SEGAINVEX-ELECTRONICA/Fuente_de_corriente_y_amplificador_bajo_ruido/readme.md

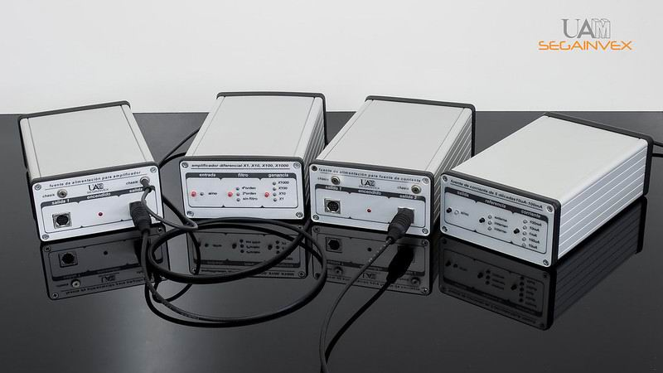
[picture p1: Fotos/IMG0.jpg]
Optional title

# UNIVERSIDAD AUTÓNOMA DE MADRID
# SEGAINVEX-Electrónica
Patricio Coronado Collado marzo 2015
# DESCRIPCIÓN
Fuentes de corriente de bajo ruido 1mA-100mA y 100nA a 1mA y amplificador diferencial con ganancias de 1 a 1000
Desarrollado por SEGAINVEX-Electrónica para el Departamento de Física de la Materia
Condensada de la UAM https://www.fmc.uam.es/
# FOTOS
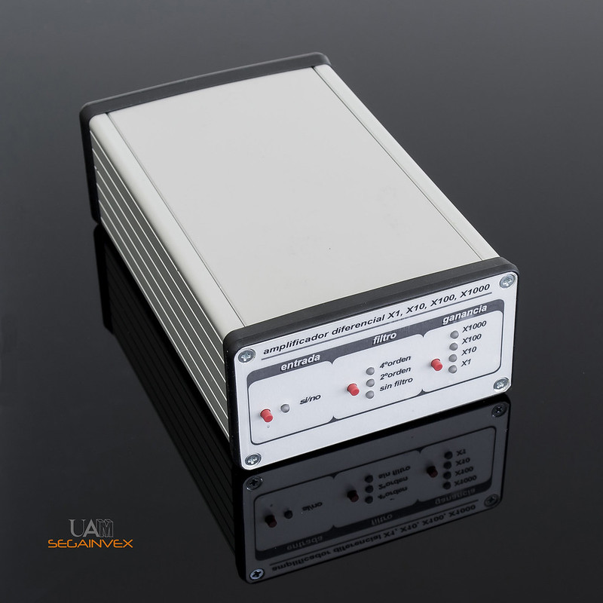
[picture p2: Fotos/IMG1.jpg]
amplificador

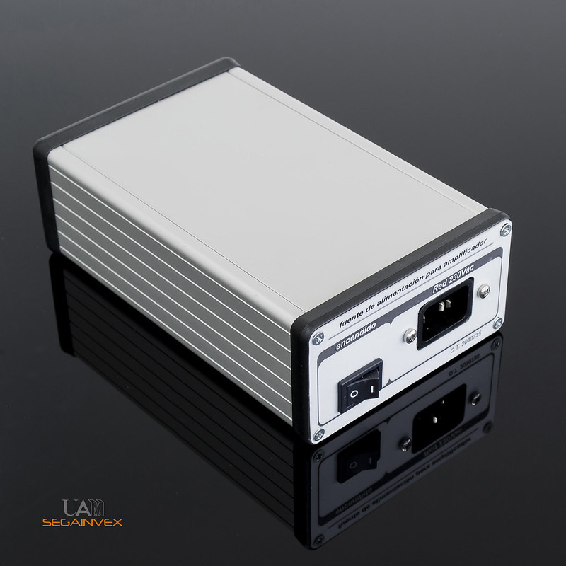
[picture p3: Fotos/IMG2.jpg]
fuente de alimentación

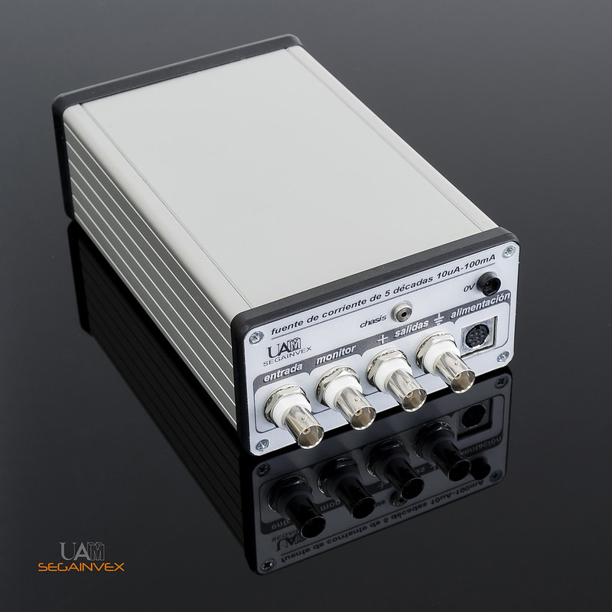
[picture p4: Fotos/IMG3.jpg]
fuente de corriente

### publicado desde "D:\Proyectos\Fuente corriente bajo riudo GitHub"
