SEGAINVEX-ELECTRONICA/Fuente_de_corriente_y_amplificador_bajo_ruido/amplificador_firmware_P89LPC935_P89LPC933/Configuración de puertos P89LPC933.JPG

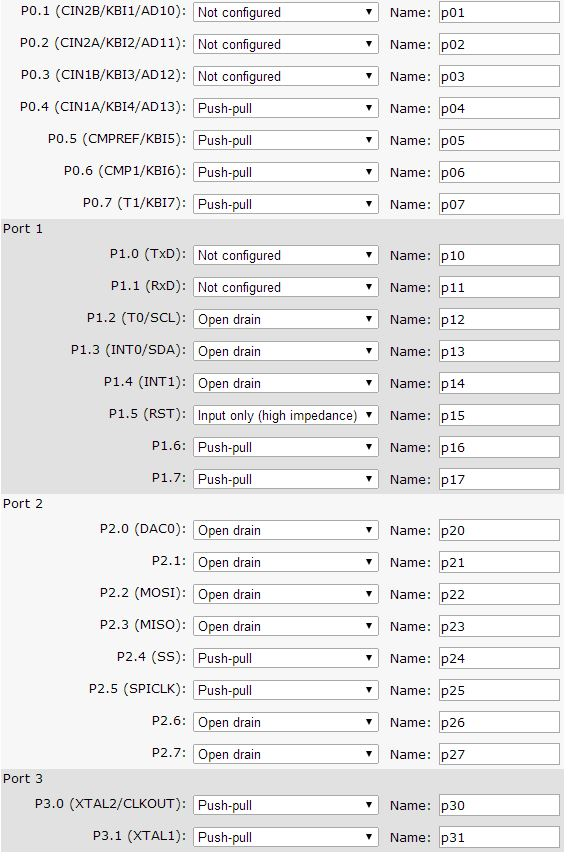
amplificador_firmware_P89LPC935_P89LPC933/Configuración de puertos P89LPC933.JPG
