SEGAINVEX-ELECTRONICA/Fuente_de_corriente_y_amplificador_bajo_ruido/(list of files, cad)

Other CAD files:
amplificador_firmware_P89LPC935_P89LPC933/START900.OBJ
fuente_corriente_firmware_LPC933/START900.OBJ
amplificador_firmware_P89LPC935_P89LPC933/ControlFuenteCorriente.OBJ
fuente_corriente_firmware_LPC933/ControlFuenteCorriente.OBJ
amplificador_firmware_P89LPC935_P89LPC933/ControlDigitalAmpDifP89LPC935.OBJ
amplificador_firmware_P89LPC935_P89LPC933/eeprom.OBJ
