SEGAINVEX-ELECTRONICA/Fuente_de_corriente_y_amplificador_bajo_ruido/Manuales/Amplificador_manual.pdf

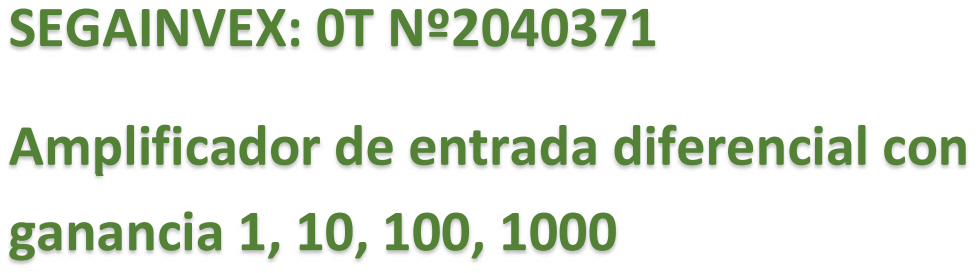
[picture p6: figure]
SEGAINVEX: 0T Nº2040371; Amplificador de entrada diferencial con ganancia 1, 10, 100, 1000
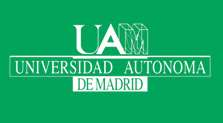
[picture p7: figure]

PARÁMETRO | VALOR
Ganancia | Seleccionable X1, X10, X100, X1000
Etapa de entrada | Diferencial
Rechazo al modo común CMRR | 100dB @ 20KHz y Ganancia 1000
Máximo voltaje de entrada diferencial | ±10V
Máximo voltaje de entrada modo común | ±9V @ (salida = ±10V) ±12V @(salida =±1V)
Impedancia de entrada diferencial | 4GΩ||1.25pF
Corriente de polarización de entrada | 5nA<50nA@25ºC
Voltaje de error de offset | -5mV @ (Ganancia=1000)
Ruido referido a la entrada (con filtro 2º orden) | 12,6nV/√Hz @(Ganancia=1000)
Corriente de salida en cortocircuito | 37mA
Ancho de Banda sin filtro | 64KHz @ (Ganancia=1000 y salida=±10V)
Ancho de Banda con filtro 2º orden | 45KHz @ (Ganancia=1000 y salida=±10V)
Ancho de Banda con filtro 4º orden | 38KHz @ (Ganancia=1000 y salida=±10V)
Máximo voltaje de salida | =±10V
Impedancia de salida | ≈ 0V
Corriente de salida en cortocircuito | ≈35mA
Potencia de la fuente de salida | 20W

### Entrada:

La entrada diferencial de señal se realiza a través de 2 conectores BNC aislados con la malla puesta a gnd (referencia de la electrónica del sistema), pero desconectada del chasis, que está completamente aislado. Para mayor flexibilidad, en el panel de conectores hay dos conectores para bornas de 2mm, conectadas una al chasis y otra a gnd.
Con el pulsador de esta etapa podemos conectar las entradas del amplificador a los conectores BNC (led encendido). O cortocircuitarlas y ponerlas a gnd, quedando los conectores BNC al aire (led apagado).

### Filtro:

Con el pulsador de filtro se puede conectar el BNC de salida a la salida del amplificador directamente (sin filtro). O a través de una etapa de filtrado de segundo orden (2º orden). O a través de dos etapas de filtrado de segundo orden (4º orden).

### Salida:

La salida se realiza a través de un conector tipo BNC aislado con la malla conectada a gnd.

### Alimentación:

La fuente de alimentación se conecta al amplificador con un conector MiniDin de 8 contactos

### 1 gnd digital 2 tierra 3 gnd digital 4 gnd analógica

5 +5V
6 -15V

### 7 gnd analógica

8 +15V

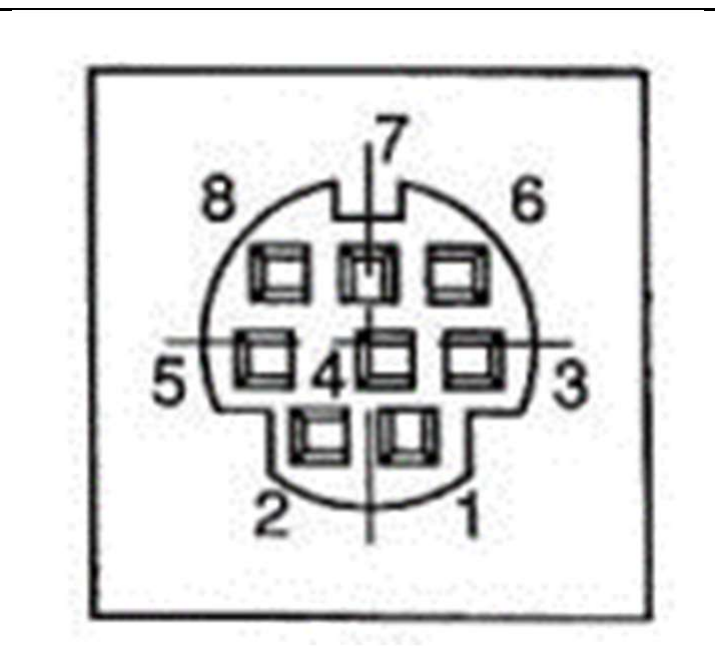
[picture p8: figure]

Por seguridad, el chasis de la fuente de alimentación está conectado a la tierra de la toma de tensión de red.

### Oscilogramas:

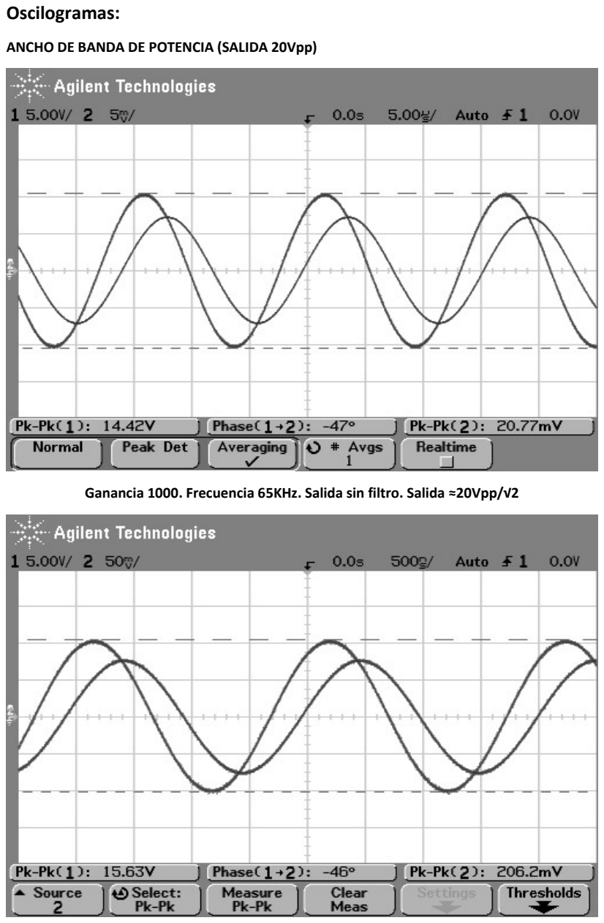
[picture p9: page 3]

ANCHO DE BANDA DE POTENCIA (SALIDA 20Vpp)

Ganancia 1000. Frecuencia 65KHz. Salida sin filtro. Salida ≈20Vpp/√2

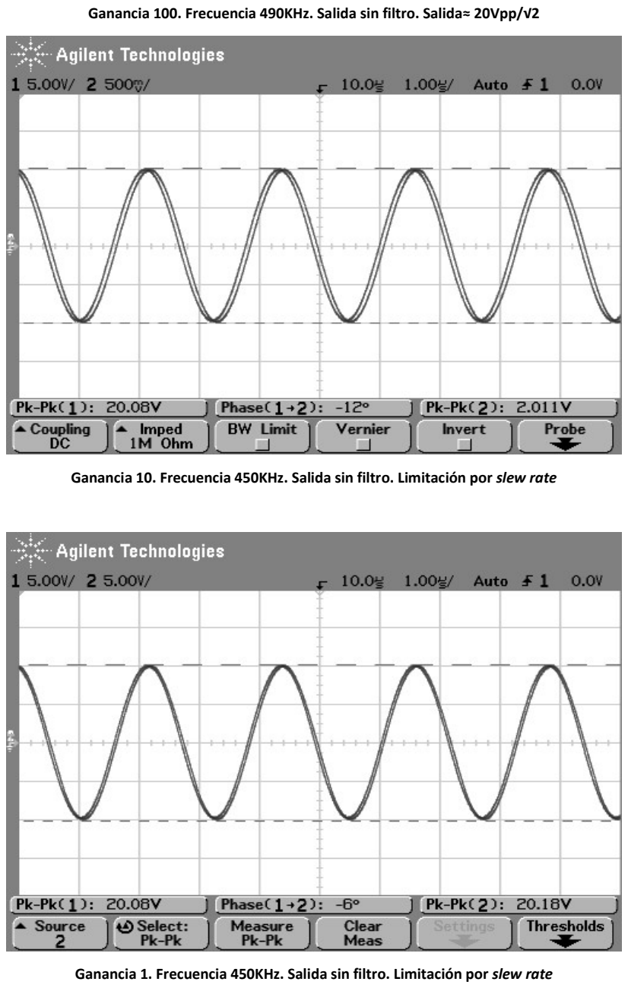
[picture p10: page 4]

Ganancia 100. Frecuencia 490KHz. Salida sin filtro. Salida≈ 20Vpp/√2

Ganancia 10. Frecuencia 450KHz. Salida sin filtro. Limitación por slew rate

Ganancia 1. Frecuencia 450KHz. Salida sin filtro. Limitación por slew rate

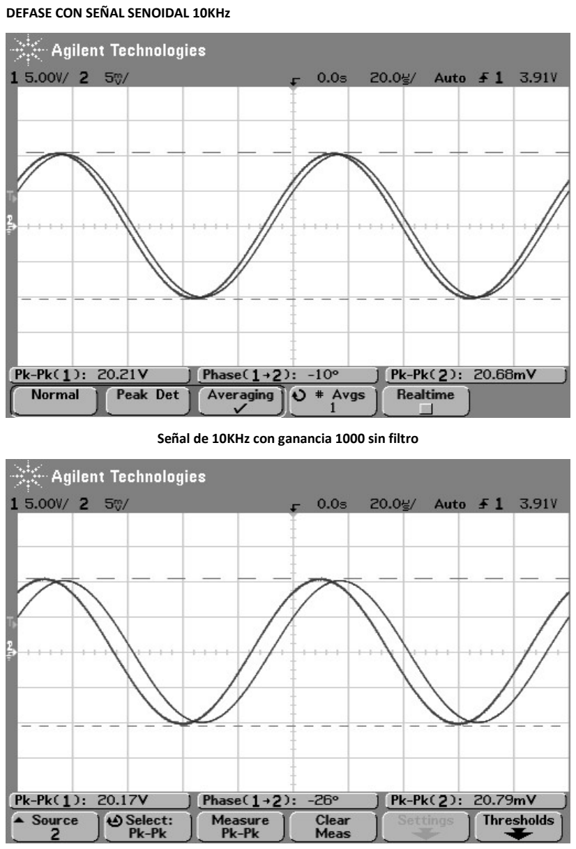
[picture p11: page 5]

DEFASE CON SEÑAL SENOIDAL 10KHz

Señal de 10KHz con ganancia 1000 sin filtro

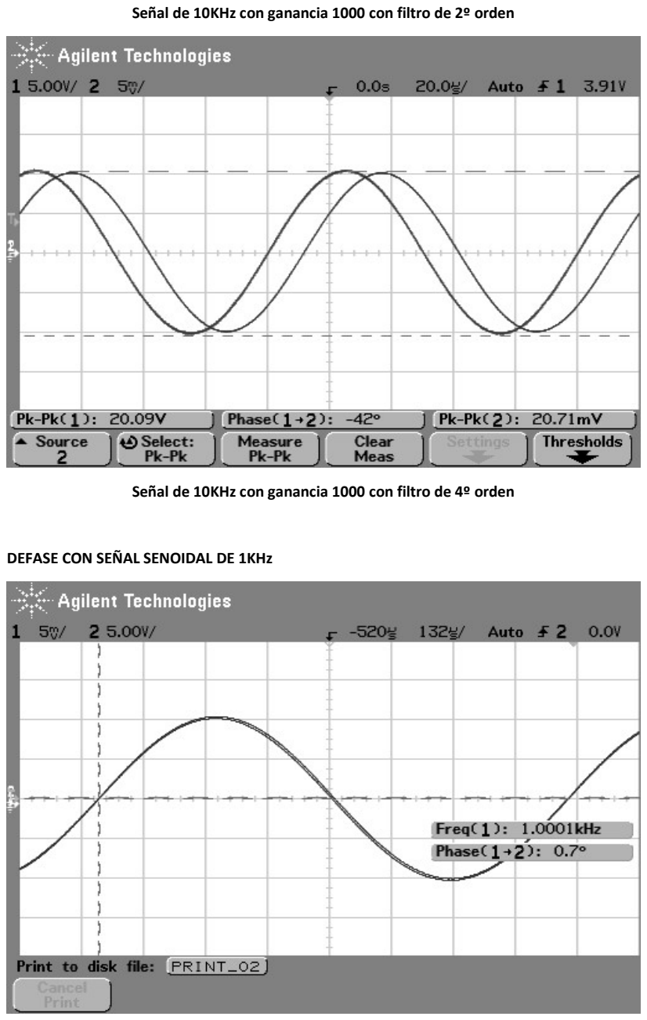
[picture p12: page 6]

Señal de 10KHz con ganancia 1000 con filtro de 2º orden

Señal de 10KHz con ganancia 1000 con filtro de 4º orden

DEFASE CON SEÑAL SENOIDAL DE 1KHz

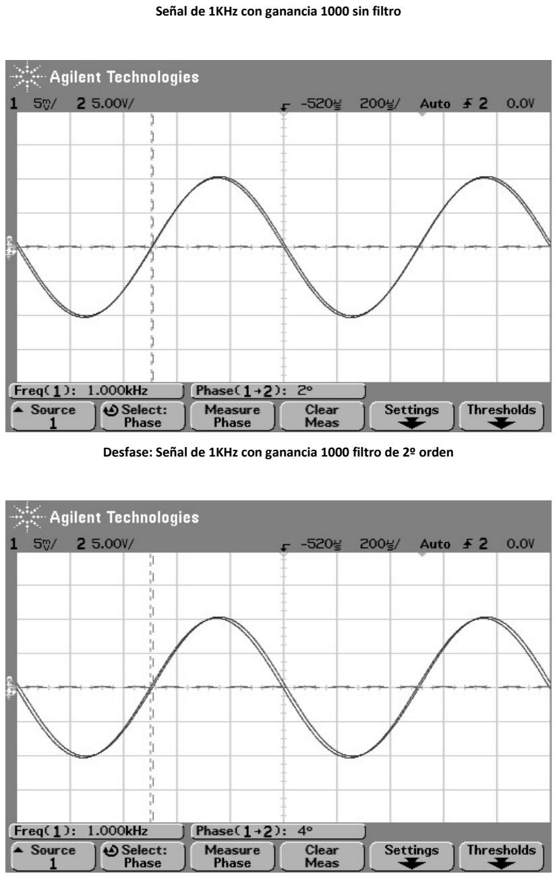
[picture p13: page 7]

Señal de 1KHz con ganancia 1000 sin filtro

Desfase: Señal de 1KHz con ganancia 1000 filtro de 2º orden

Desfase: Señal de 1KHz con ganancia 1000 filtro de 4º orden

### Ruido:

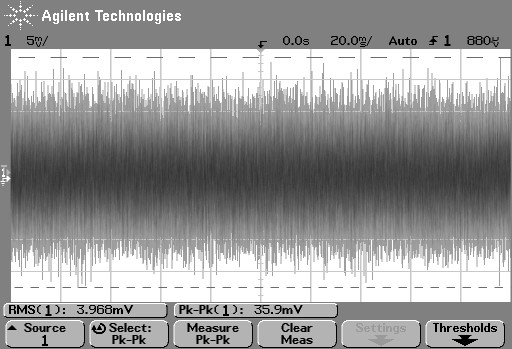
[picture p14: figure]

Ganancia 1000. Entradas a gnd. Salida sin filtro

VnRTI =

Vrms
G√B

=

3.968mV
1000√65000

=

15, 6nV
√Hz
Densidad de ruido referido a la entrada

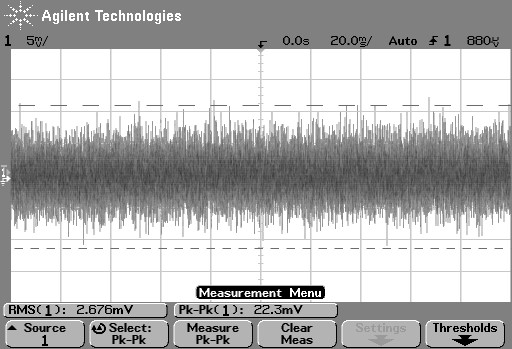
[picture p15: figure]

Ganancia 1000. Entradas a gnd. Salida con filtro 2º orden

VnRTI =

Vrms
G√B

=

2.676mV
1000√45000

=

12, 6nV
√Hz

Densidad de ruido referido a la entrada

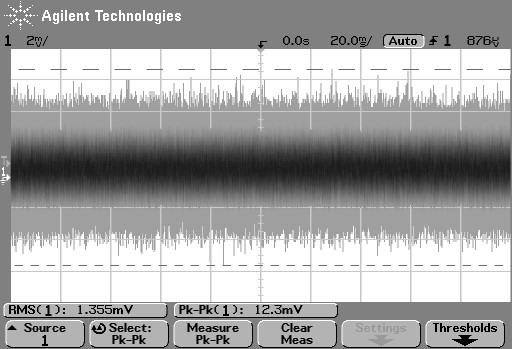
[picture p16: figure]

Ganancia 100. Entradas a gnd. Salida sin filtro

VnRTI =

Vrms
G√B

=

1.355mV
100√490000

=

19, 35nV
√Hz
Densidad de ruido referido a la entrada

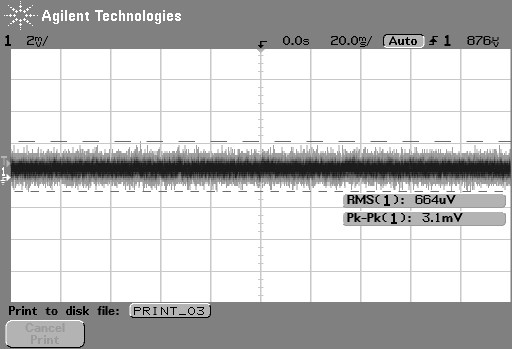
[picture p17: figure]

Ganancia 100. Entradas a gnd. Salida con filtro 2º orden

VnRTI =

Vrms
G√B

=

0.664mV
1000√45000

=

31, 6nV
√Hz
Densidad de ruido referido a la entrada

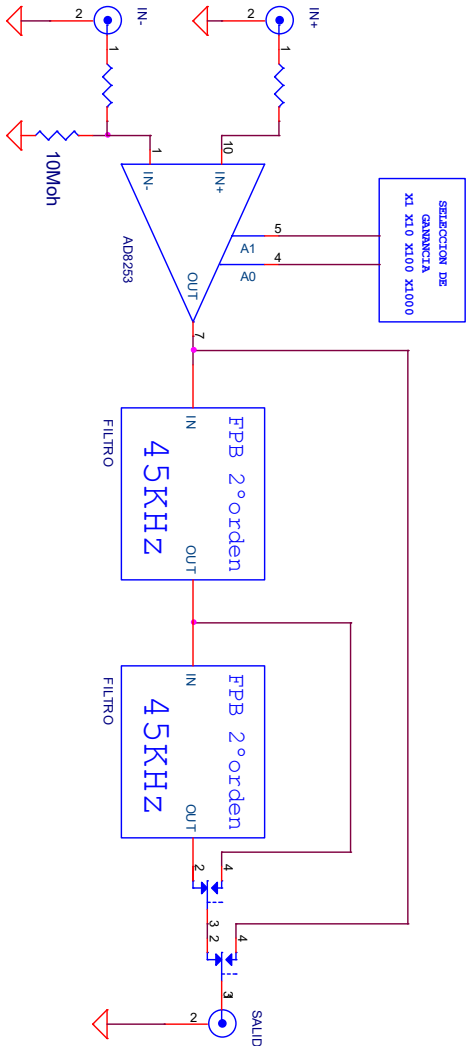
[picture p18: figure]

SALIDA 1 2 FPB 2ºorden 45KHz FILTRO IN OUT IN- 1 2 3 24 AD8253 IN- 1 IN+ 10 4 A0 5 A1 7 OUT FPB 2ºorden 45KHz FILTRO IN OUT 10Moh IN+ 1 2 3 24 X1 X10 X100 X1000 GANANCIA SELECCION DE
