SEGAINVEX-ELECTRONICA/Fuente_de_corriente_y_amplificador_bajo_ruido/Manuales/Fuente_corriente_1mA_manual_y_esquemas.pdf

## Manual. Fuente de corriente 2040370 V1.0 2015

# SEGAINVEX: 0T Nº2040370

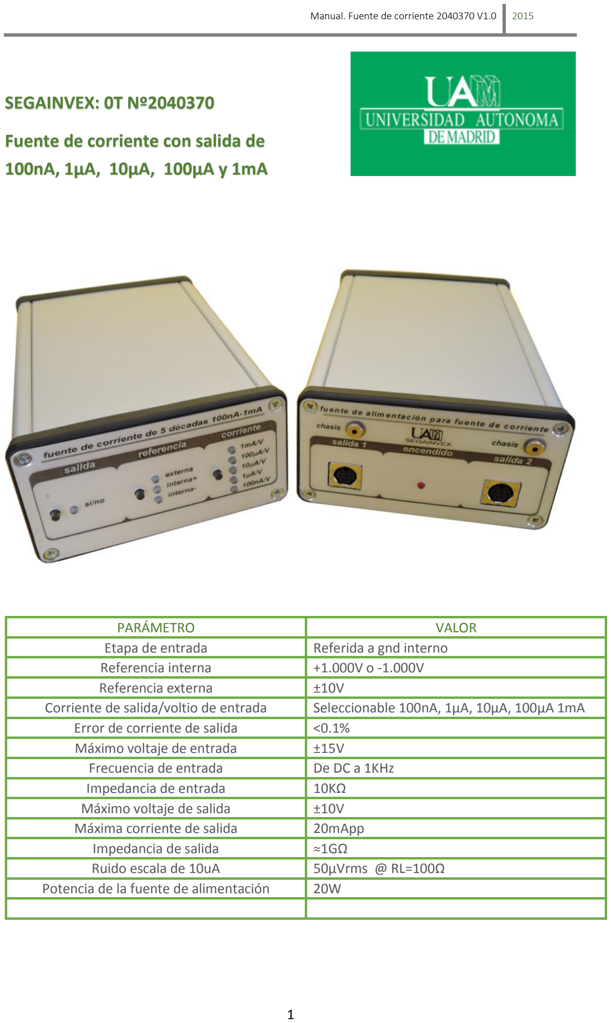
[picture p27: page 1]

# Fuente de corriente con salida de 100nA, 1µA, 10µA, 100µA y 1mA

PARÁMETRO | VALOR
Etapa de entrada | Referida a gnd interno
Referencia interna | +1.000V o -1.000V
Referencia externa | ±10V
Corriente de salida/voltio de entrada | Seleccionable 100nA, 1µA, 10µA, 100µA 1mA
Error de corriente de salida | <0.1%
Máximo voltaje de entrada | ±15V
Frecuencia de entrada | De DC a 1KHz
Impedancia de entrada | 10KΩ
Máximo voltaje de salida | ±10V
Máxima corriente de salida | 20mApp
Impedancia de salida | ≈1GΩ
Ruido escala de 10uA | 50µVrms @ RL=100Ω
Potencia de la fuente de alimentación | 20W

# Entrada:

La entrada de señal se realiza a través de un conector BNC aislados con la malla puesta a gnd

# (referencia de la electrónica del sistema), pero desconectada del chasis, que está

completamente aislado. Para mayor flexibilidad, en el panel de conectores hay dos conectores para bornas de 2mm, conectadas una al chasis y otra a gnd.

# Salida:

Se realiza a través de 2 conectores BNC con las mallas aisladas y unidas entre sí. La salida

# etiquetada como + es el activo de la fuente, la etiquetada con el símbolo de gnd está

conectada a la referencia de la electrónica de la fuente.

Con el pulsador de esta etapa podemos conectar las salidas de la fuente de corriente a los

# conectores BNC de salida (led encendido). O cortocircuitar los conectores BNC entre sí y

aislarlos completamente de la fuente de corriente, quedando al aire.

# Monitor:

En el conector BNC la salida “monitor” está conectada a una tensión igual a corriente de salida multiplicado por la resistencia de precisión sensora de corriente. Su valor coincide con la tensión de referencia.

# Referencia:

Con el pulsador de referencia se puede seleccionar entre la entada de referencia externa, o la referencia interna de 1,000 voltio o -1,000 voltio.

# Alimentación:

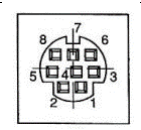
[picture p28: figure]

# 1 gnd digital 2 tierra 3 gnd digital 4 gnd analógica

5 +5V
6 -15V

# 7 gnd analógica

8 +15V

La fuente de alimentación se conecta a la fuente de corriente con un conector MiniDin de 8 contactos. Por seguridad, el chasis de la fuente de alimentación está conectado a la tierra de la

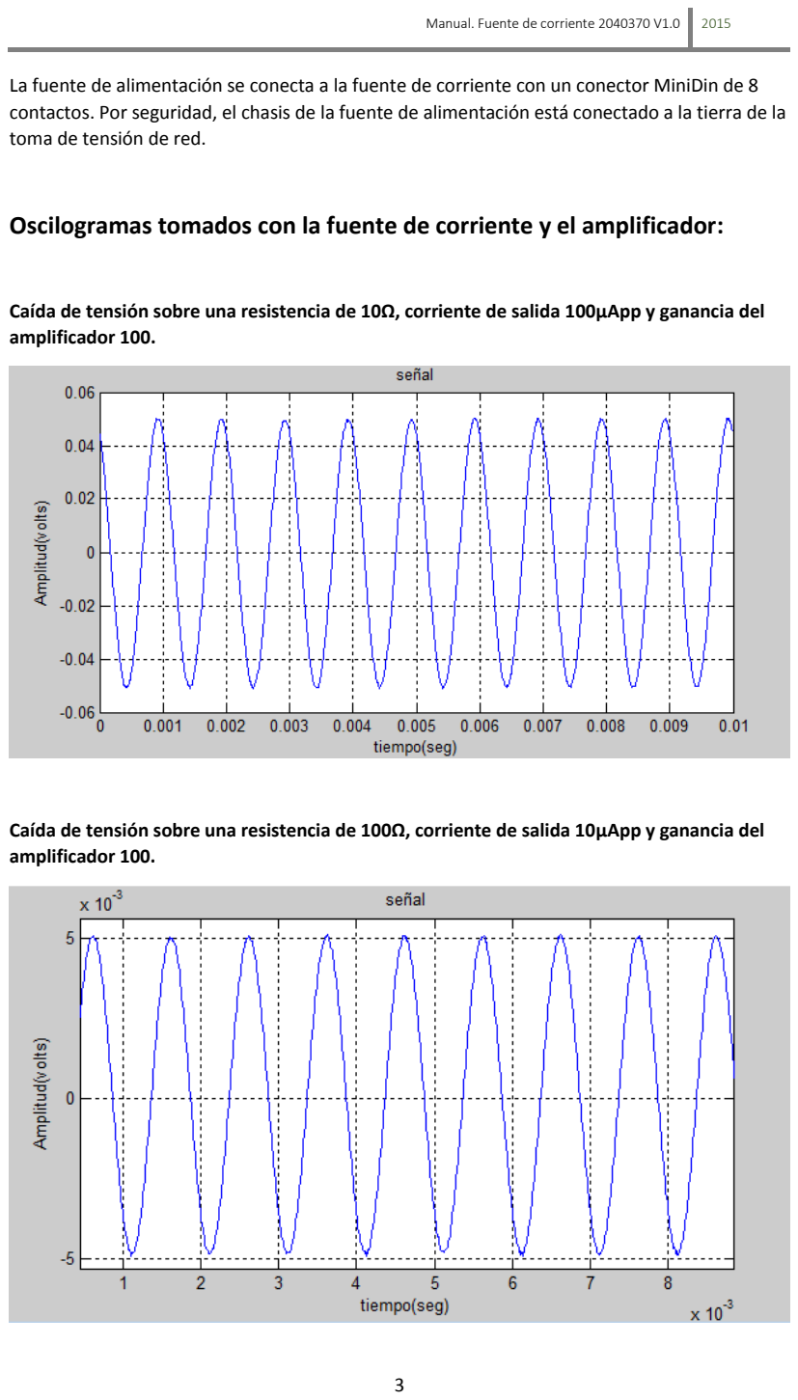
[picture p29: page 3]

toma de tensión de red.

# Oscilogramas tomados con la fuente de corriente y el amplificador:

# Caída de tensión sobre una resistencia de 10Ω, corriente de salida 100µApp y ganancia del

amplificador 100.

# Caída de tensión sobre una resistencia de 100Ω, corriente de salida 10µApp y ganancia del

amplificador 100.

# Caída de tensión sobre una resistencia de 1KΩ, corriente de salida 10µApp y ganancia del

amplificador 10.

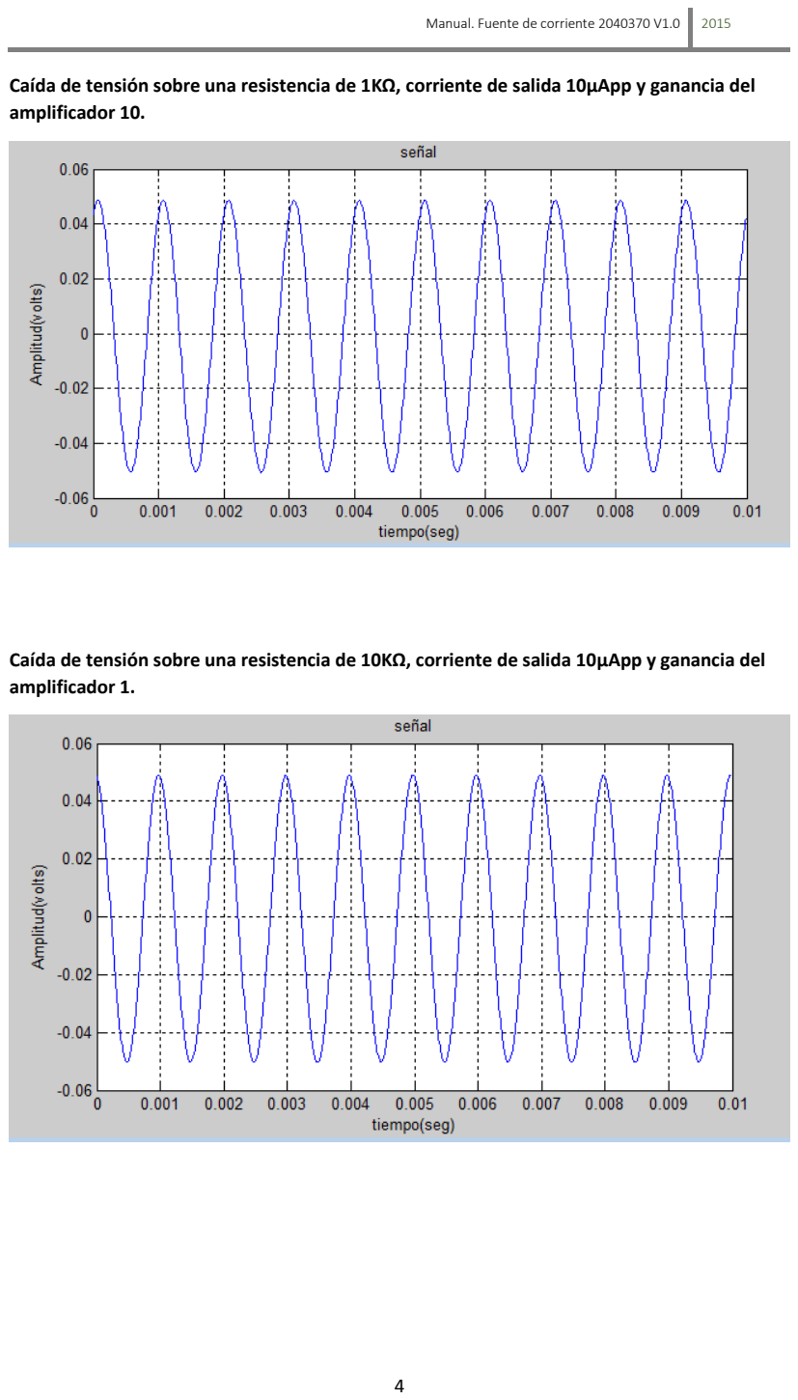
[picture p30: page 4]

# Caída de tensión sobre una resistencia de 10KΩ, corriente de salida 10µApp y ganancia del

amplificador 1.

## GND_ANALOGICO

## GND_DIGITAL


10uF 50V CERAMICO
Con radiador de 30K/W
VD=13V; Imax=71mA*2; P=1.85W
Rth(j-c)TO252=8ºK/W
(Con la resistencia de 150R T=73ºC)

TIERRA EN LAS SALIDAS

PLUG AC MALE
CHASIS
Unido con un tornillo la
parte más grande de la
caja.

## RST

## RXD


Configurar los pines de
los leds como open drain

SEGAIVEX
SEGAINVEX, Dpto. Electrónica
Diseñado:
Dibujado:
Título:
Control digital de fuente de corriente de 5 decadas
Archivo:

## * R25 =10K NM Montar solo si hay

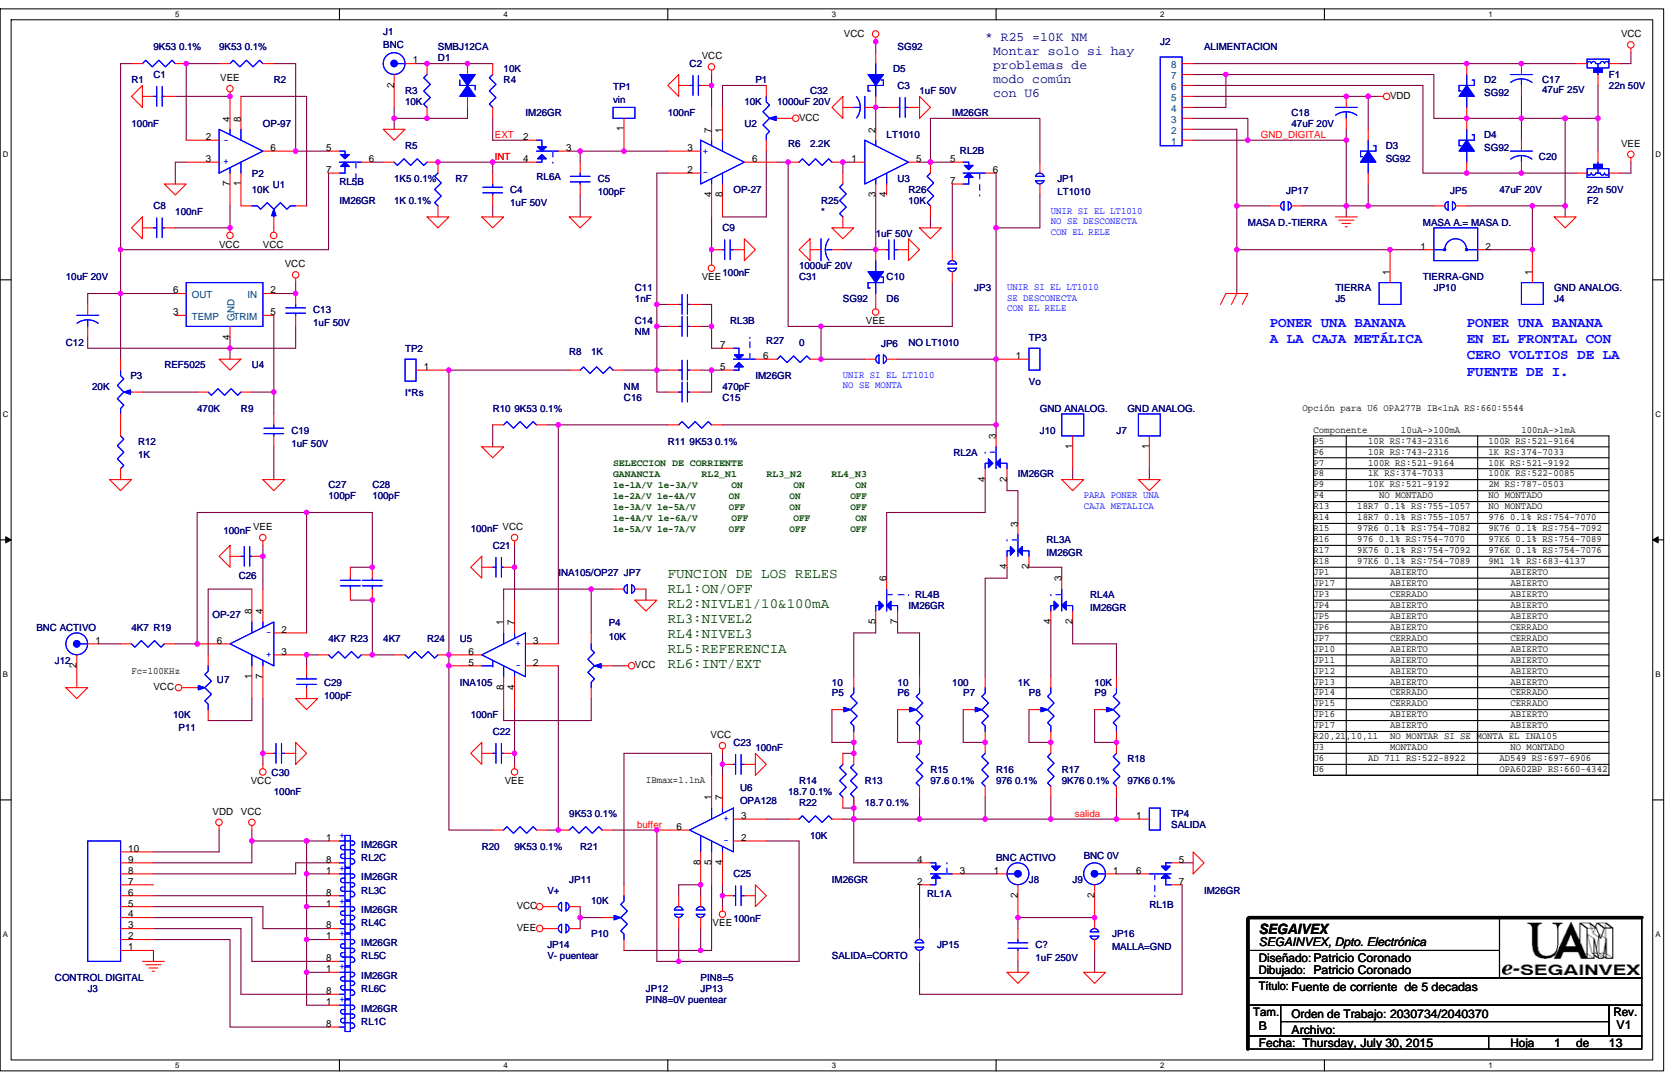
[picture p31: page 7]

PONER UNA BANANA
EN EL FRONTAL CON
CERO VOLTIOS DE LA
FUENTE DE I.

Opción para U6 OPA277B IB<1nA RS:660:5544

P5 | 10R RS:743-2316 | 100R RS:521-9164
P6 | 10R RS:743-2316 | 1K RS:374-7033
P7 | 100R RS:521-9164 | 10K RS:521-9192
P8 | 1K RS:374-7033 | 100K RS:522-0085
P9 | 10K RS:521-9192 | 2M RS:787-0503
P4 | NO MONTADO | NO MONTADO
R13 | 18R7 0.1% RS:755-1057 | NO MONTADO
R14 | 18R7 0.1% RS:755-1057 | 976 0.1% RS:754-7070
R15 | 97R6 0.1% RS:754-7082 | 9K76 0.1% RS:754-7092
R16 | 976 0.1% RS:754-7070 | 97K6 0.1% RS:754-7089
R17 | 9K76 0.1% RS:754-7092 | 976K 0.1% RS:754-7076
R18 | 97K6 0.1% RS:754-7089 | 9M1 1% RS:683-4137
JP1 | ABIERTO | ABIERTO
JP17 | ABIERTO | ABIERTO

JP4 | ABIERTO | ABIERTO
JP5 | ABIERTO | ABIERTO
JP6 | ABIERTO | CERRADO

JP10 | ABIERTO | ABIERTO
JP11 | ABIERTO | ABIERTO
JP12 | ABIERTO | ABIERTO
JP13 | ABIERTO | ABIERTO
JP14 | CERRADO | CERRADO
JP15 | CERRADO | CERRADO
JP16 | ABIERTO | ABIERTO

R20,21,10,11 NO MONTAR SI SE | | MONTA EL INA105
U3 | MONTADO | NO MONTADO
U6 | AD 711 RS:522-8922 | AD549 RS:697-6906
U6 | | OPA602BP RS:660-4342

SEGAIVEX
SEGAINVEX, Dpto. Electrónica
Diseñado:
Dibujado:
Título:
Fuente de corriente de 5 decadas
