SEGAINVEX-ELECTRONICA/Fuente_de_corriente_y_amplificador_bajo_ruido/Manuales/Amplificador_esquema.pdf

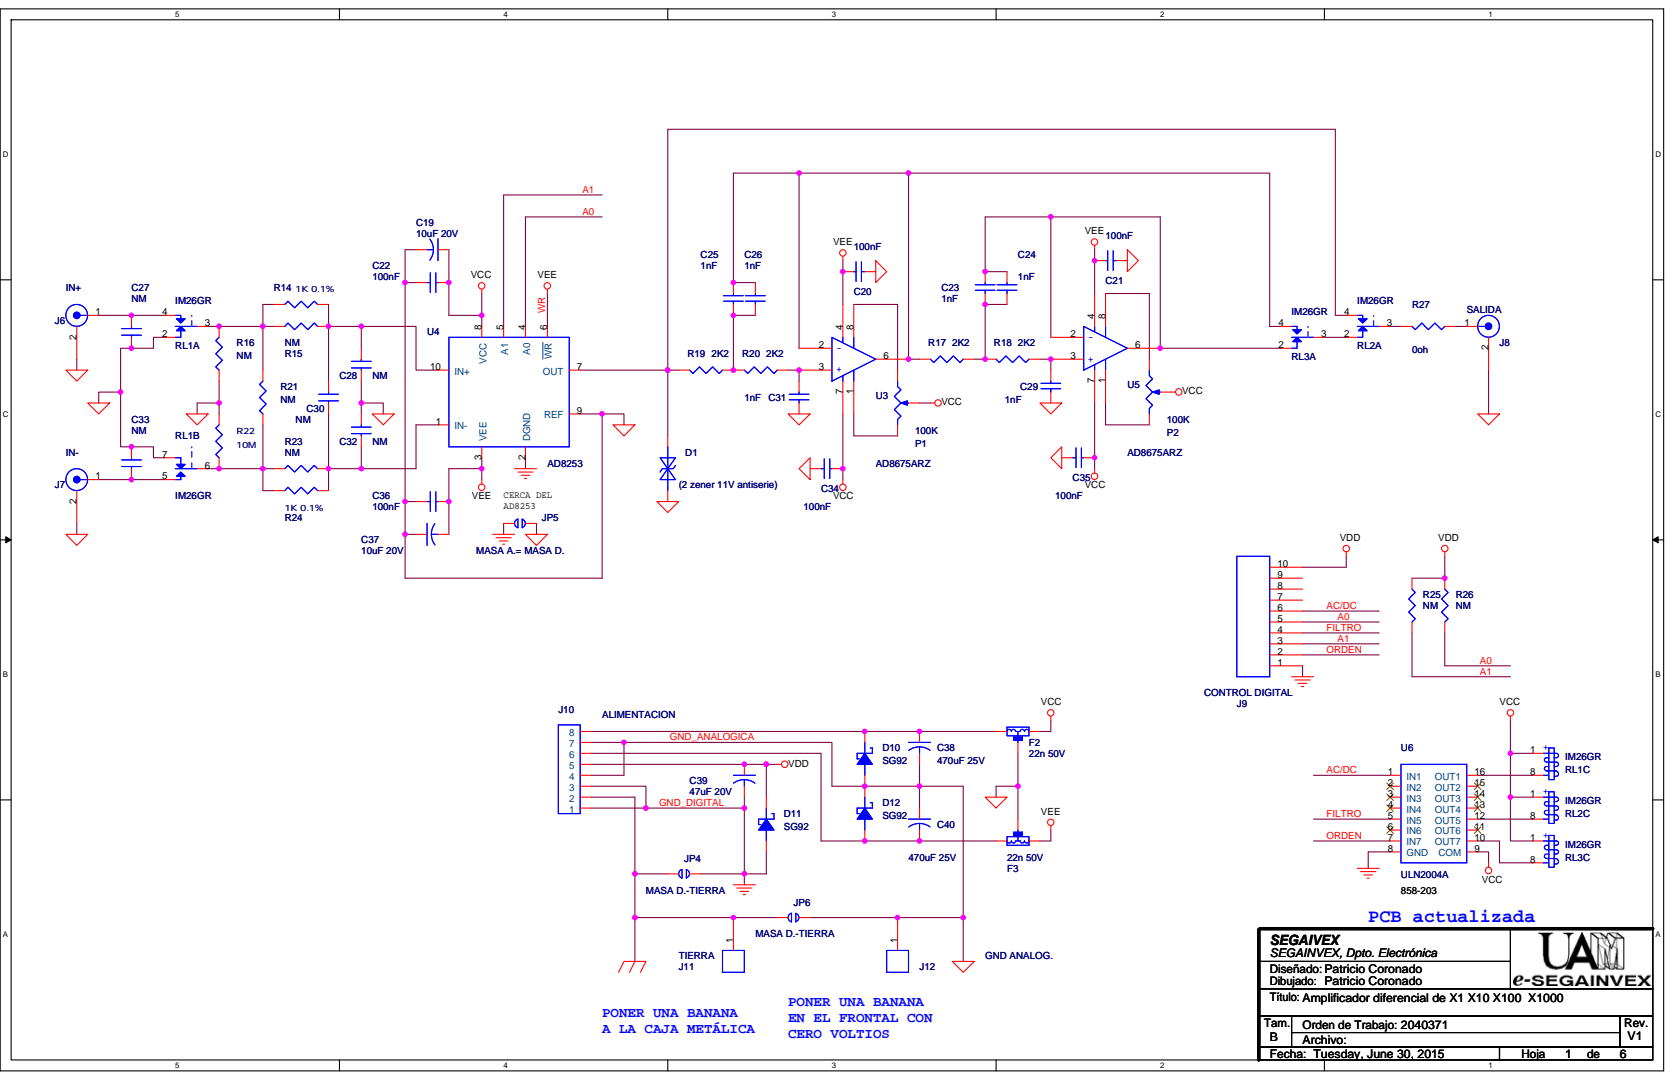
[picture p46: page 1]

PONER UNA BANANA
EN EL FRONTAL CON
CERO VOLTIOS
