SEGAINVEX-ELECTRONICA/Fuente_de_corriente_y_amplificador_bajo_ruido/Manuales/Amplificador_control_digital.pdf

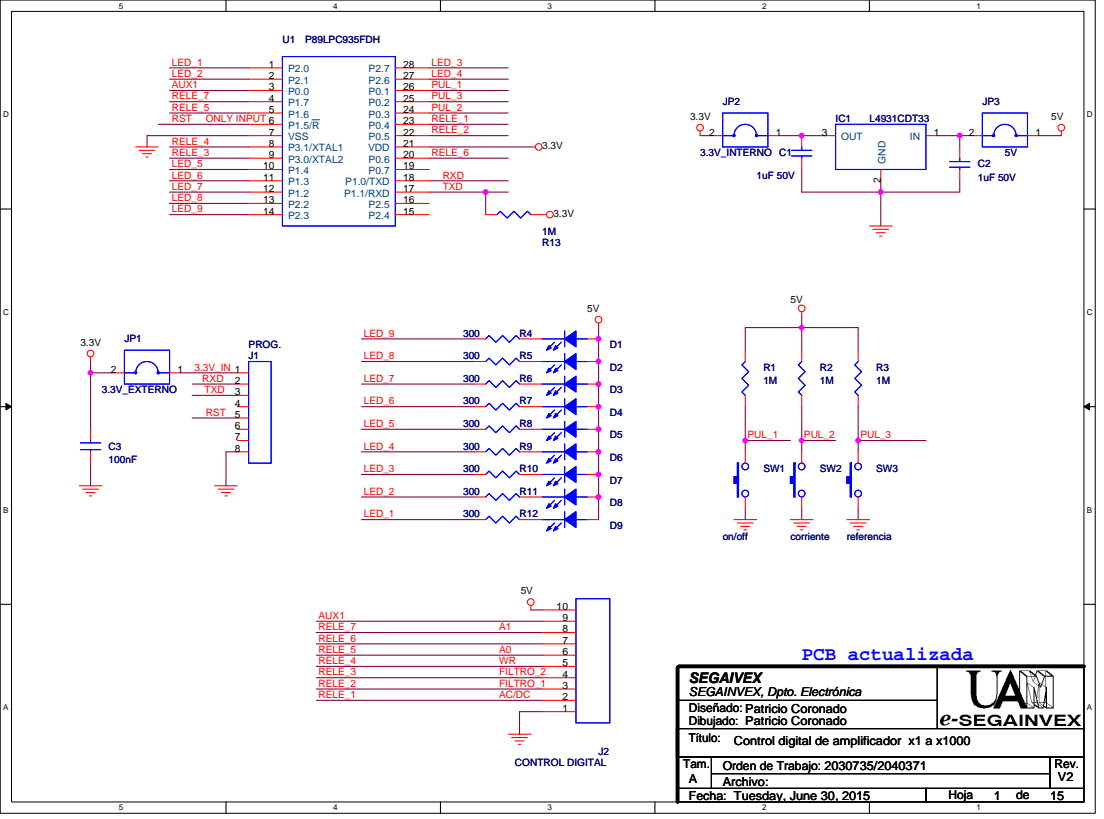
[picture p47: page 1]

Patricio Coronado
Control digital de amplificador x1 a x1000
