SEGAINVEX-ELECTRONICA/Fuente_de_corriente_y_amplificador_bajo_ruido/Manuales/Amplificador_esquema_conceptual.pdf

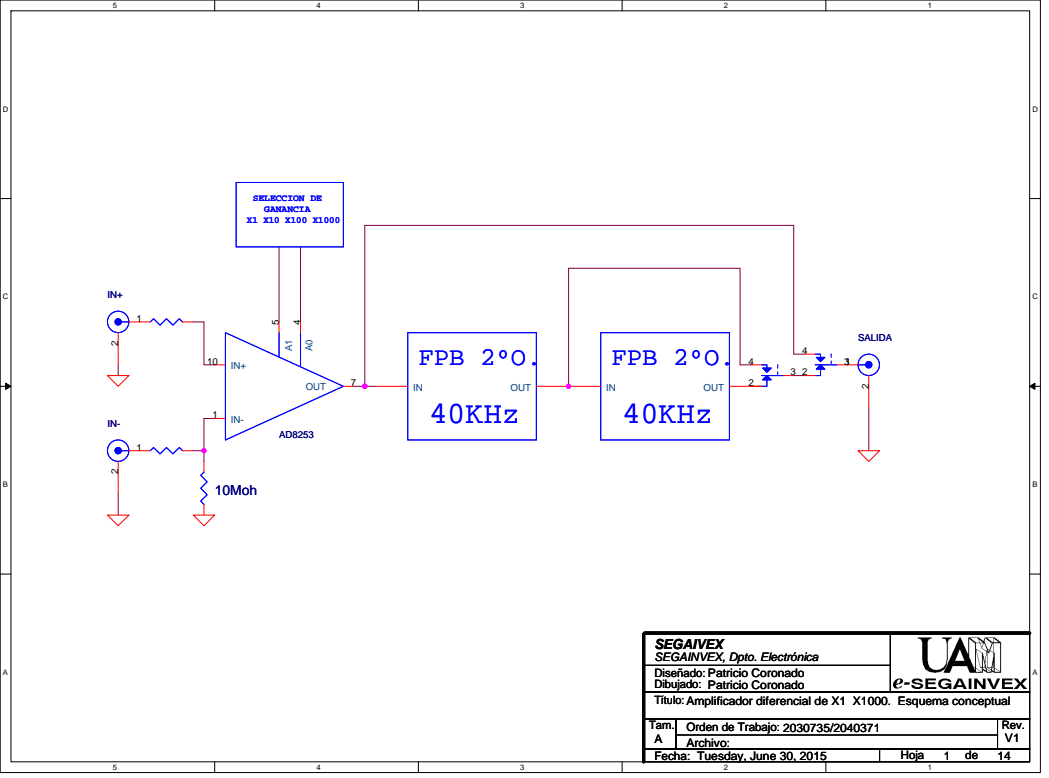
[picture p48: page 1]
Tam.; Orden de Trabajo:; Rev.; Fecha:; Hoja; Patricio Coronado; Tuesday, June 30, 2015; SALIDA; FPB 2ºO.; 40KHz; OUT; 10Moh; SELECCION DE GANANCIA X1 X10 X100 X1000

SEGAIVEX
SEGAINVEX, Dpto. Electrónica
Diseñado:
Dibujado:
Título:
Amplificador diferencial de X1 X1000. Esquema conceptual
Archivo:
